minpeter/rule60-wrist-rest/evidence/topcase/analysis/outline-overlay-v4.png

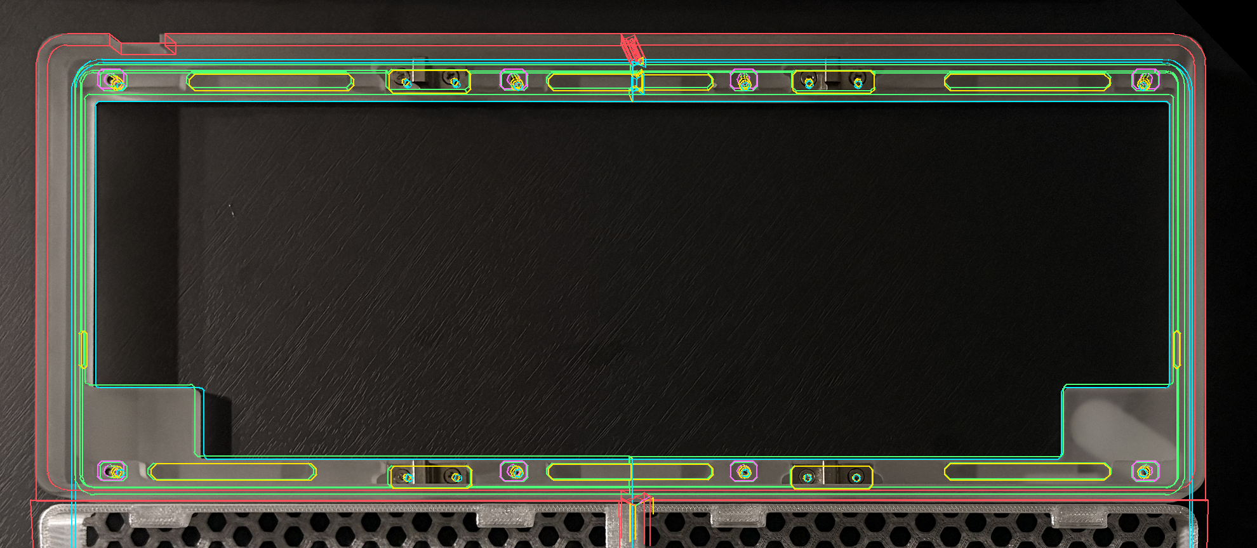
evidence/topcase/analysis/outline-overlay-v4.png
