minpeter/rule60-wrist-rest/evidence/topcase/analysis/strike-pocket-fit-v4.3.png

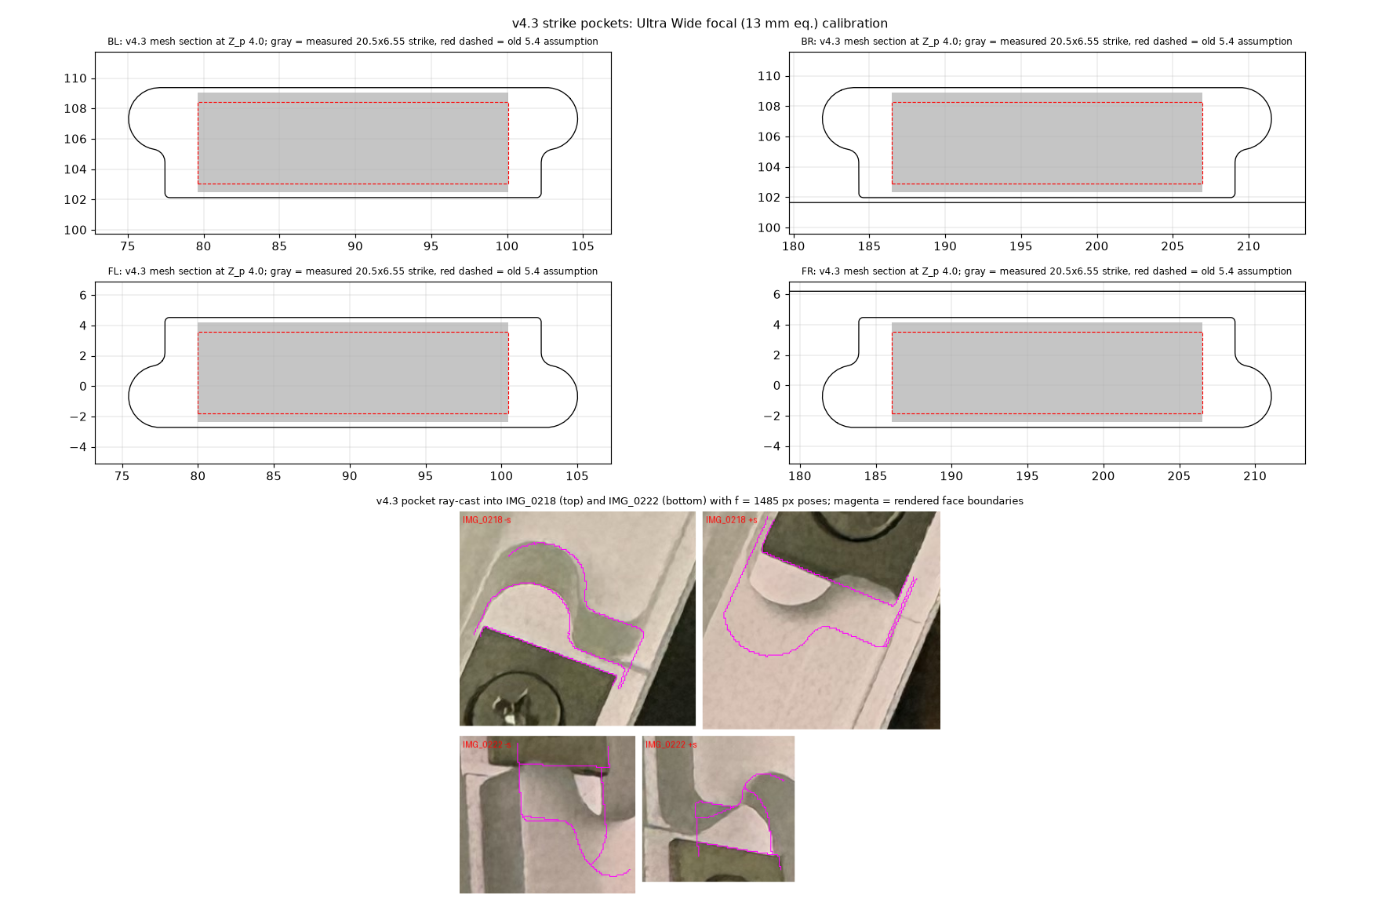
evidence/topcase/analysis/strike-pocket-fit-v4.3.png
