minpeter/rule60-wrist-rest/evidence/topcase/checks/seams-v7.4.png

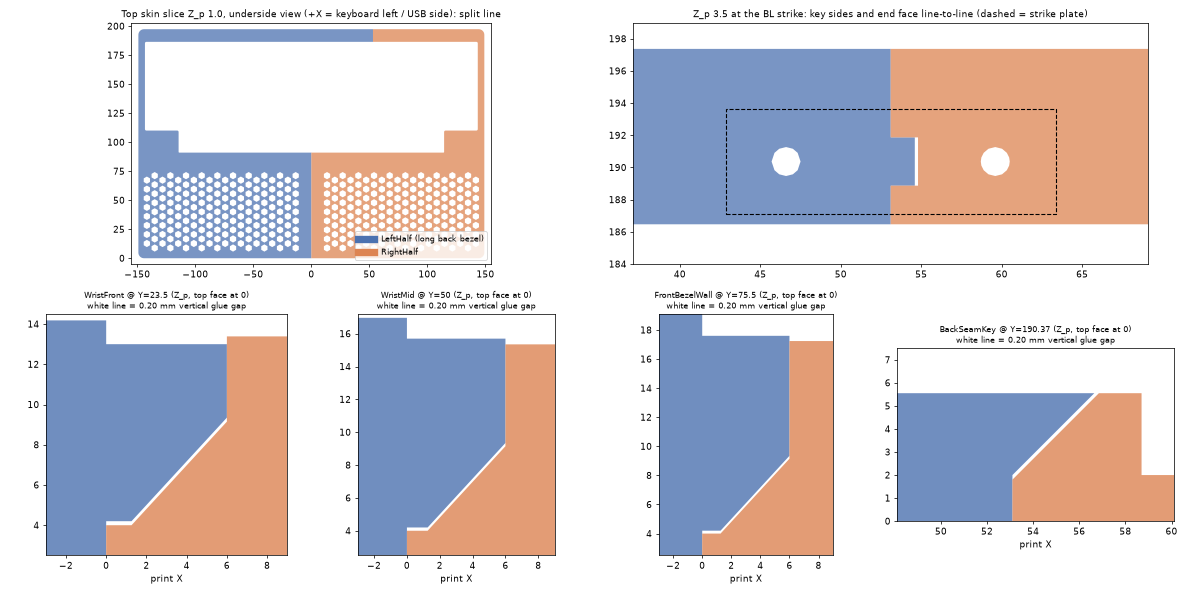
evidence/topcase/checks/seams-v7.4.png
