minpeter/rule60-wrist-rest/evidence/topcase/photos/IMG_0215.jpg

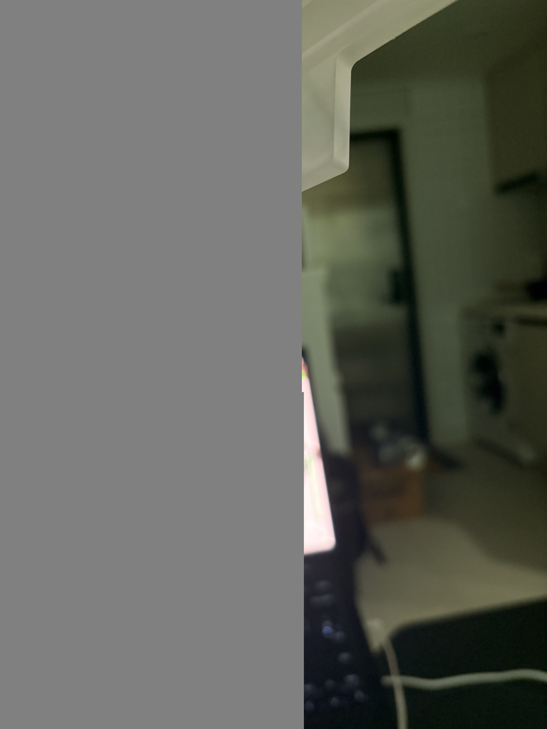
evidence/topcase/photos/IMG_0215.jpg
