minpeter/rule60-wrist-rest/evidence/topcase/photos/IMG_0216.jpg

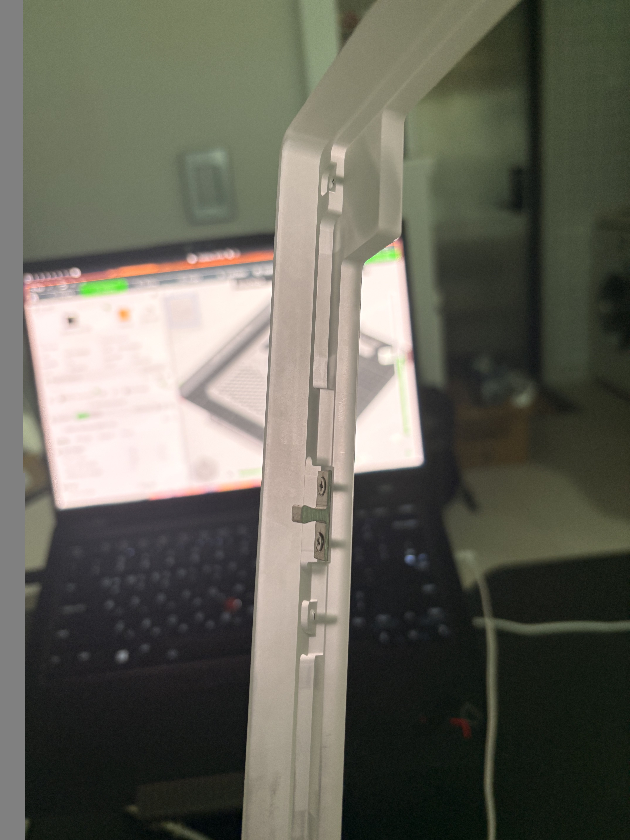
evidence/topcase/photos/IMG_0216.jpg
