minpeter/rule60-wrist-rest/evidence/topcase/photos/IMG_0217.jpg

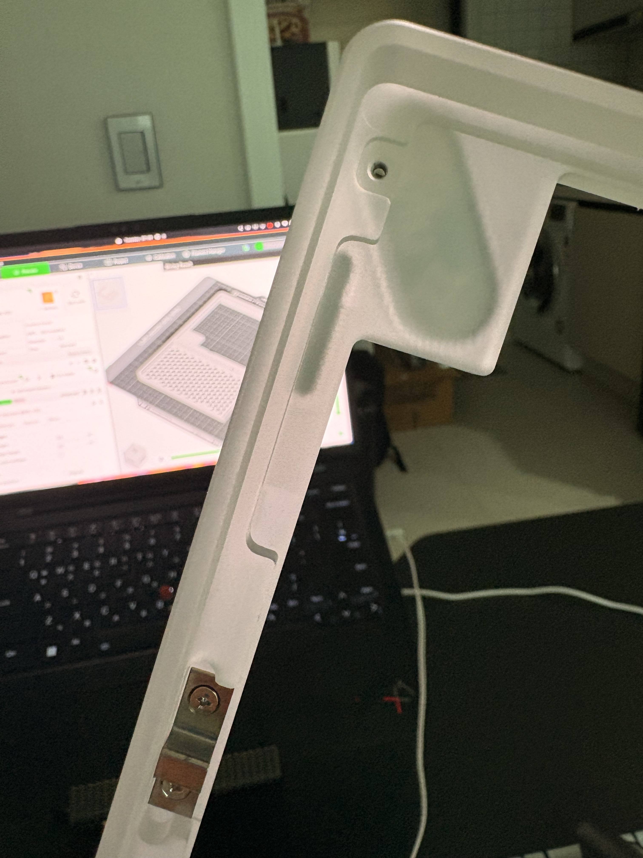
evidence/topcase/photos/IMG_0217.jpg
