minpeter/rule60-wrist-rest/evidence/topcase/photos/IMG_0218.jpg

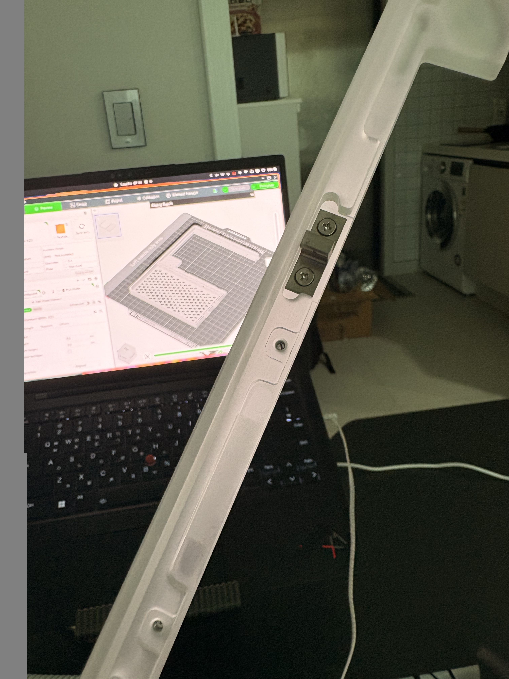
evidence/topcase/photos/IMG_0218.jpg
