minpeter/rule60-wrist-rest/evidence/topcase/photos/IMG_0220.jpg

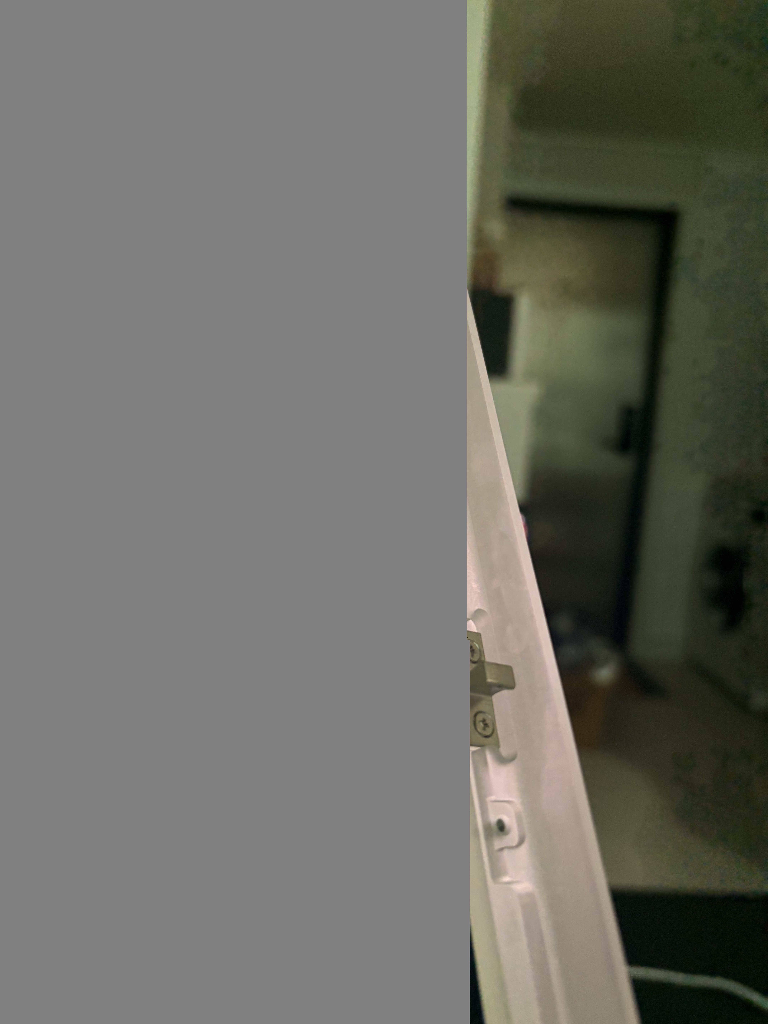
evidence/topcase/photos/IMG_0220.jpg
