minpeter/rule60-wrist-rest/evidence/topcase/photos/IMG_0222.jpg

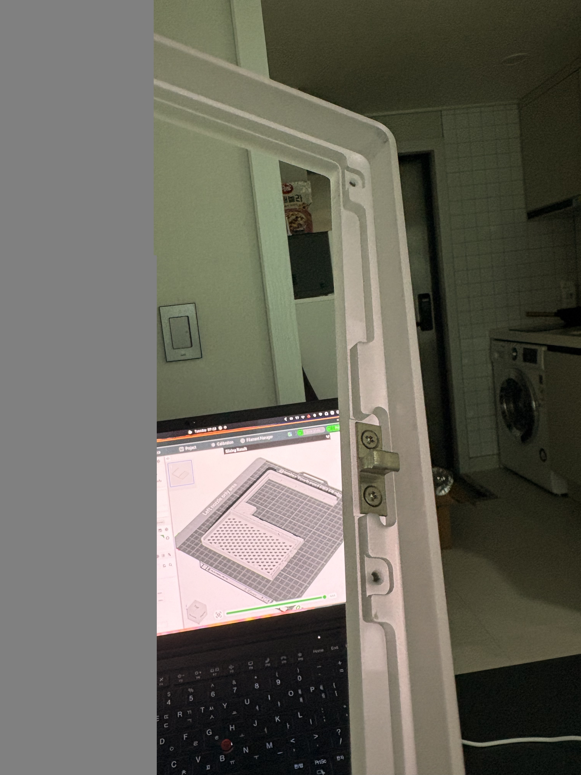
evidence/topcase/photos/IMG_0222.jpg
