minpeter/rule60-wrist-rest/evidence/topcase/photos/IMG_0313.jpg

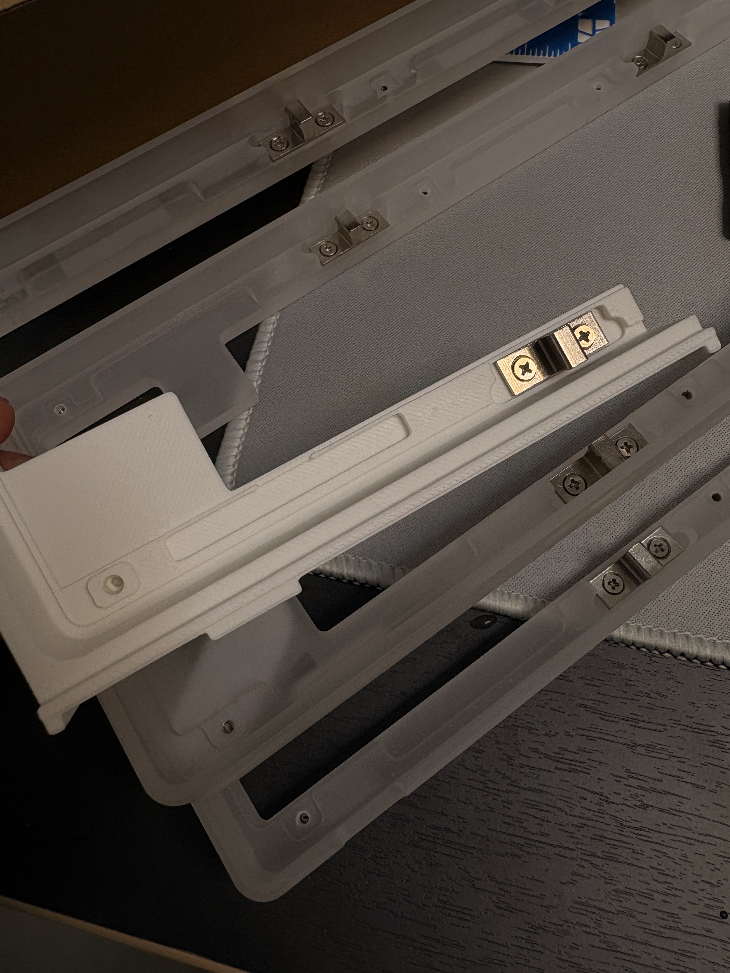
evidence/topcase/photos/IMG_0313.jpg
