minpeter/rule60-wrist-rest/evidence/topcase/photos/IMG_0314.jpg

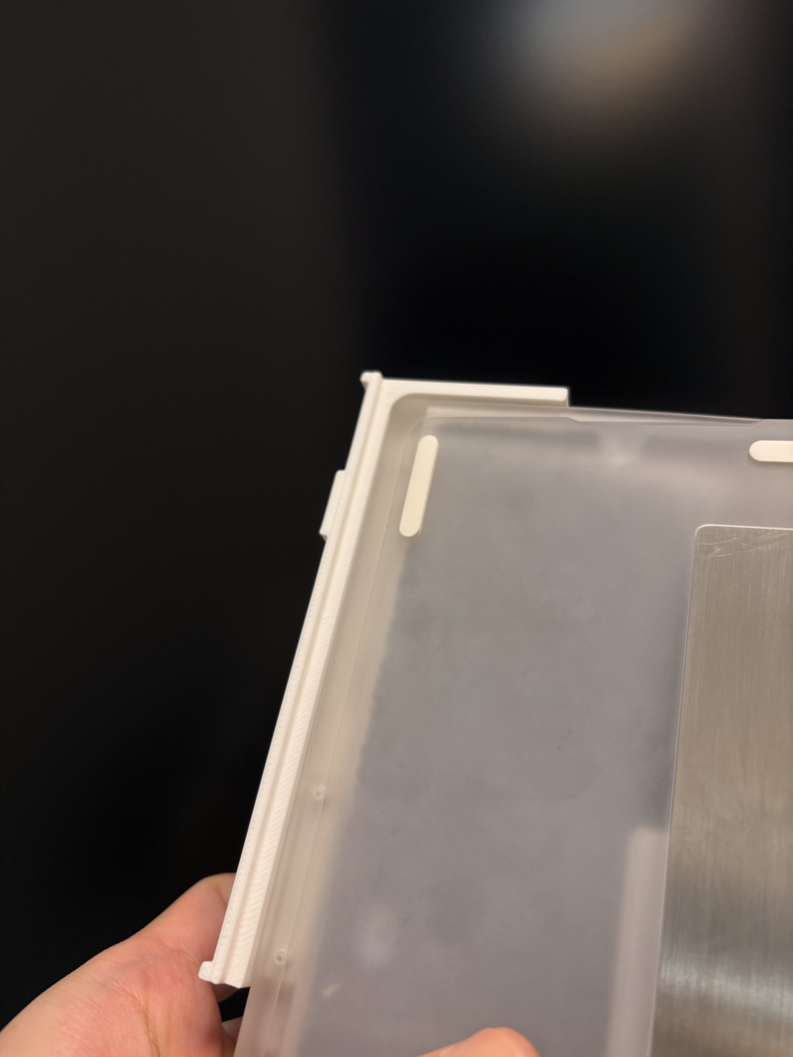
evidence/topcase/photos/IMG_0314.jpg
