minpeter/rule60-wrist-rest/evidence/topcase/photos/IMG_0340.jpg

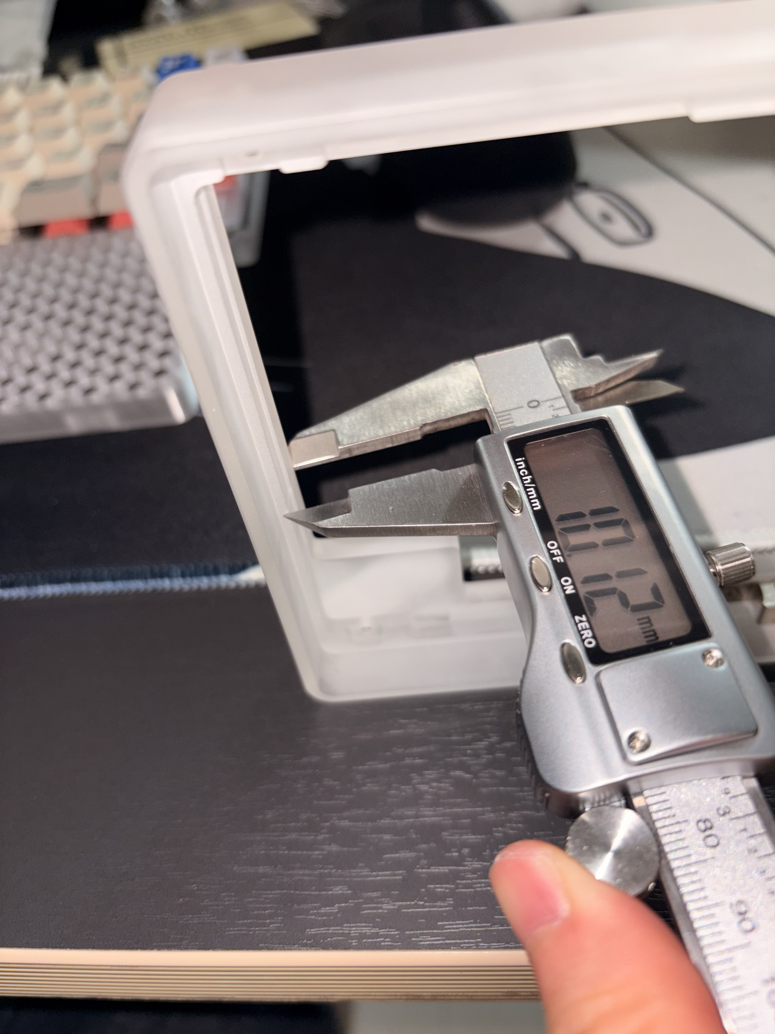
evidence/topcase/photos/IMG_0340.jpg
