minpeter/rule60-wrist-rest/evidence/topcase/photos/IMG_0341.jpg

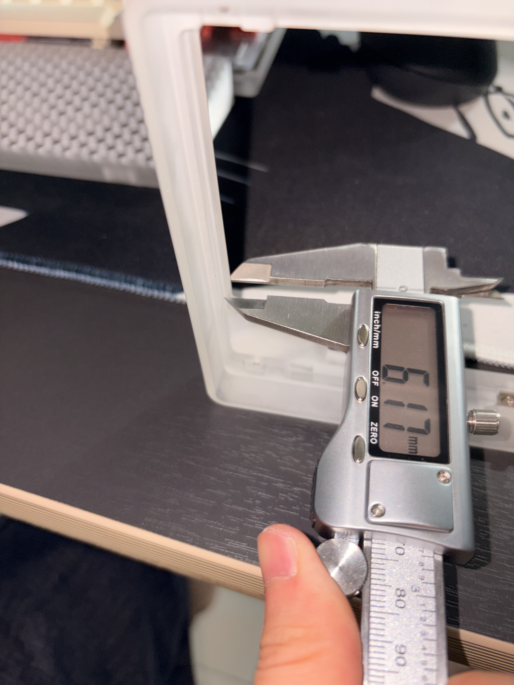
evidence/topcase/photos/IMG_0341.jpg
