minpeter/rule60-wrist-rest/evidence/topcase/photos/IMG_0370.jpg

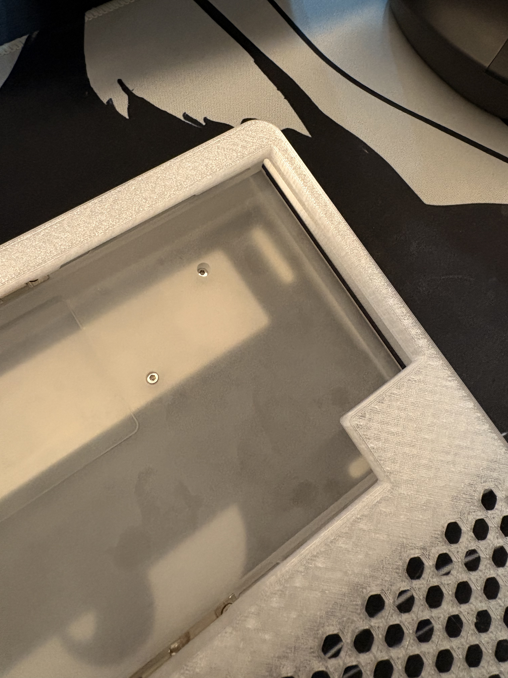
evidence/topcase/photos/IMG_0370.jpg
