minpeter/rule60-wrist-rest/evidence/topcase/photos/IMG_0371.jpg

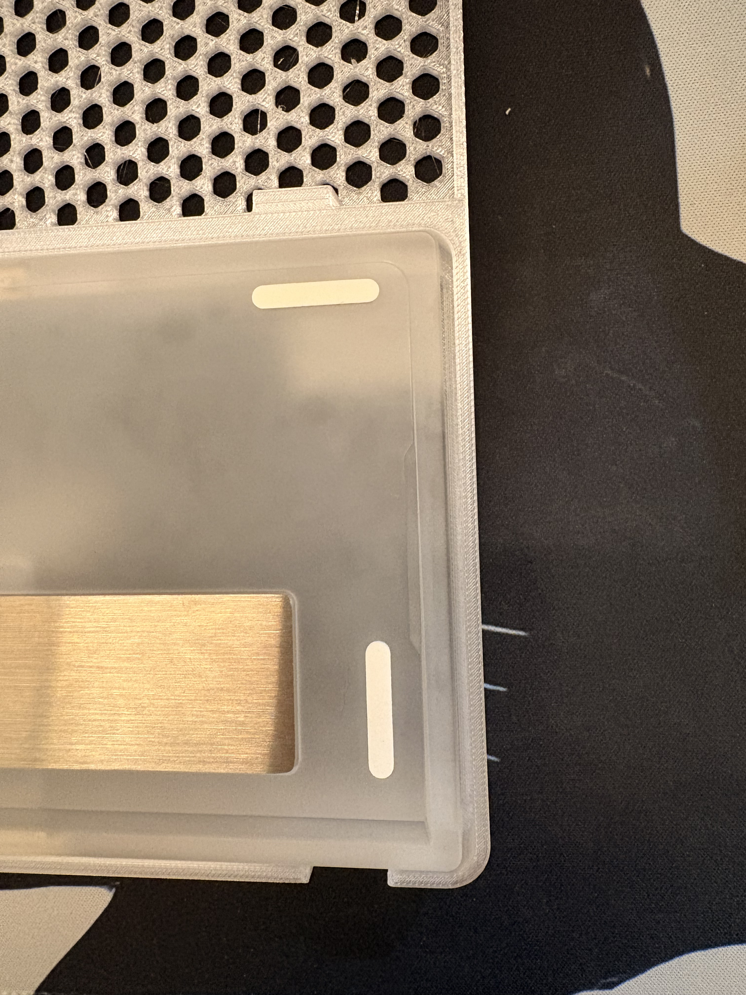
evidence/topcase/photos/IMG_0371.jpg
