minpeter/rule60-wrist-rest/evidence/topcase/photos/IMG_0373.jpg

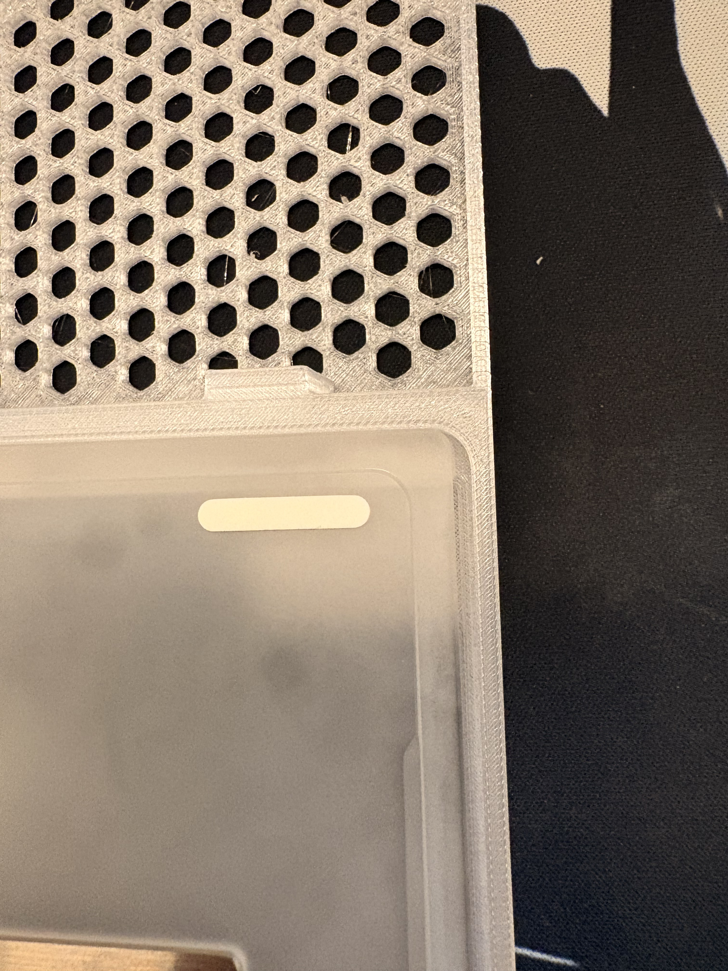
evidence/topcase/photos/IMG_0373.jpg
