minpeter/rule60-wrist-rest/evidence/topcase/photos/IMG_0375.jpg

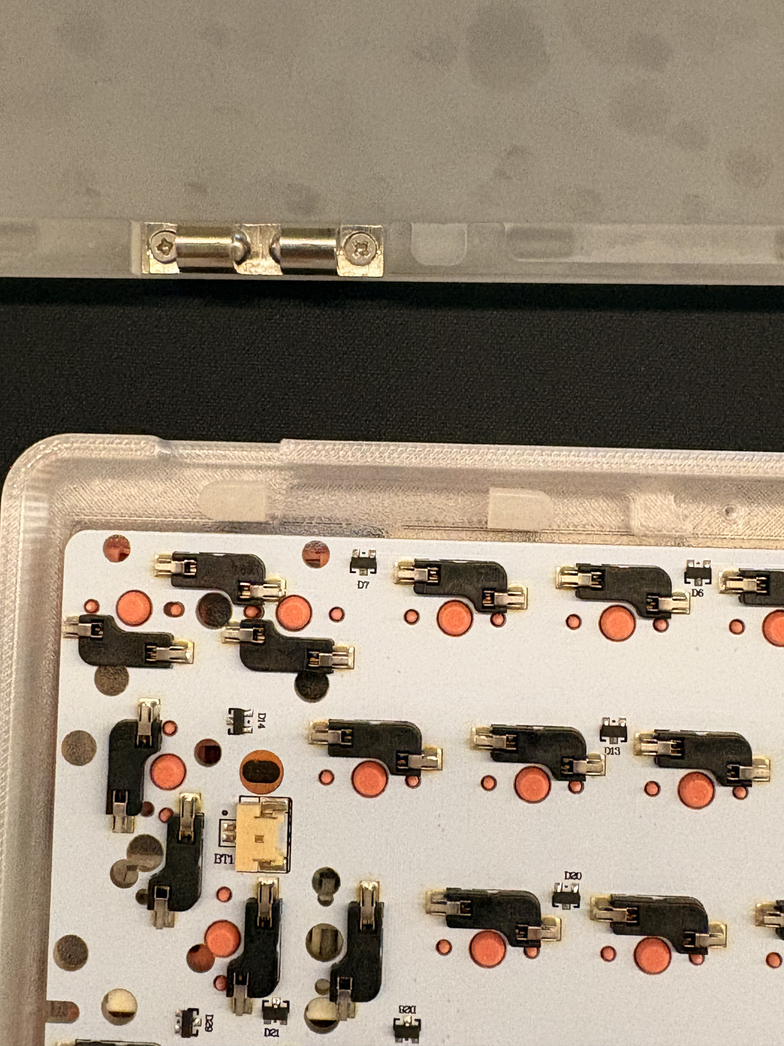
evidence/topcase/photos/IMG_0375.jpg
