minpeter/rule60-wrist-rest/evidence/topcase/photos/IMG_0378.jpg

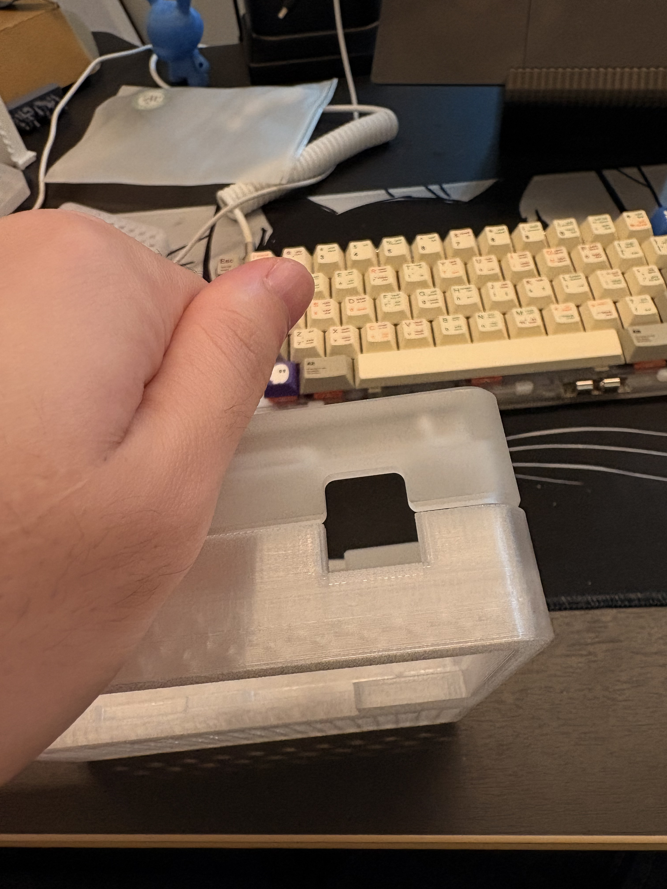
evidence/topcase/photos/IMG_0378.jpg
