minpeter/rule60-wrist-rest/evidence/topcase/photos/IMG_0379.jpg

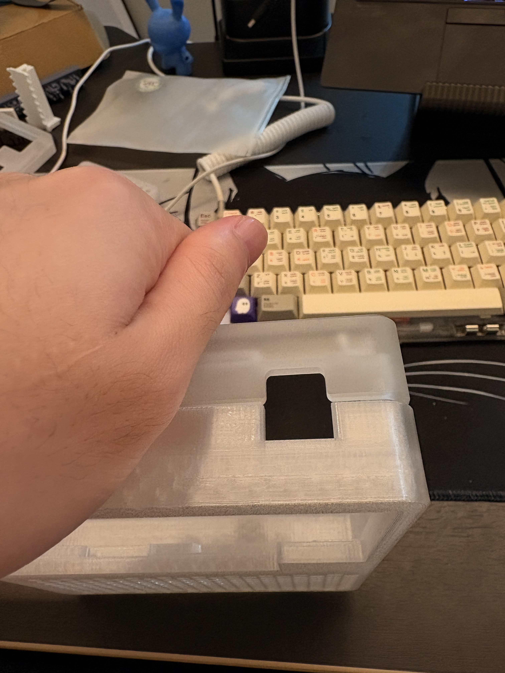
evidence/topcase/photos/IMG_0379.jpg
