minpeter/rule60-wrist-rest/images/top.png

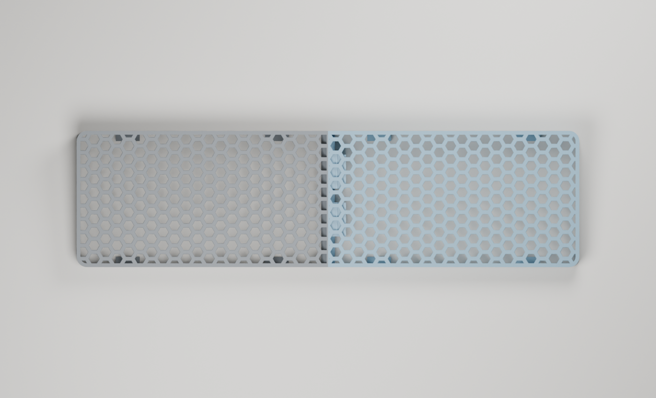
images/top.png
