minpeter/rule60-wrist-rest/rendering/v7_1/keycaps_v7_1/textures/0_1.png

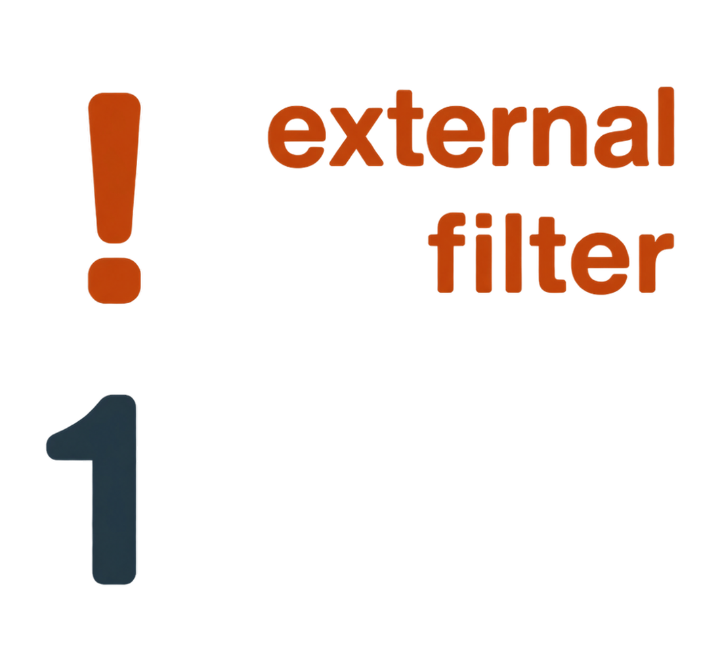
rendering/v7_1/keycaps_v7_1/textures/0_1.png
