minpeter/rule60-wrist-rest/rendering/v7_1/keycaps_v7_1/textures/3_LeftShift.png

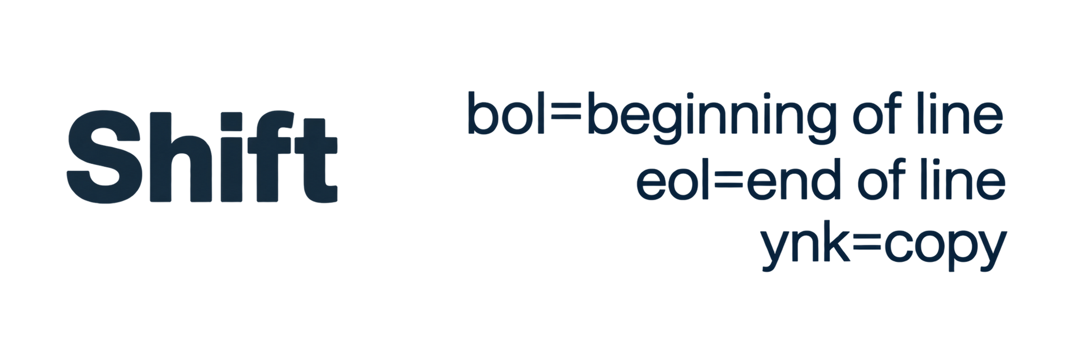
rendering/v7_1/keycaps_v7_1/textures/3_LeftShift.png
