minpeter/rule60-wrist-rest/rendering/v7_1/sample_frame_007.png

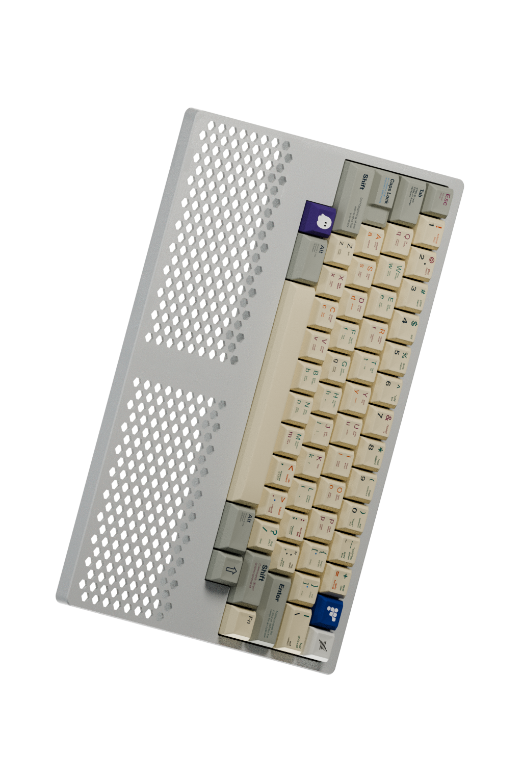
rendering/v7_1/sample_frame_007.png
