minpeter/rule60-wrist-rest/rendering/v7_1/shell_assembled.stl

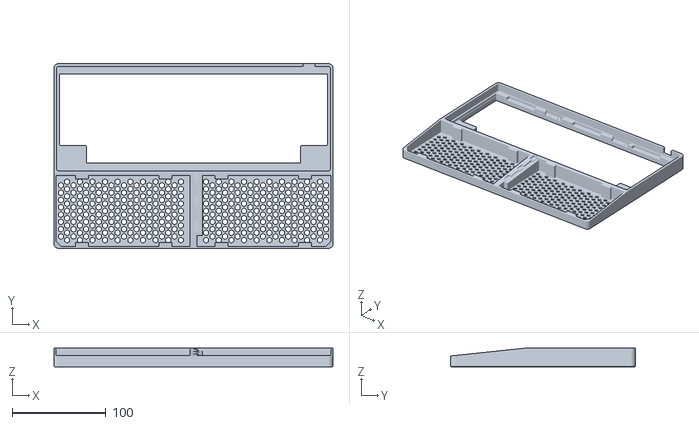
[picture p94: CAD file, 2026-10-31]
rendering/v7_1/shell_assembled.stl
298.1 x 197.4 x 20.1
