minpeter/rule60-wrist-rest/models/rule60-hhkb-topcase-fit-coupons.3mf

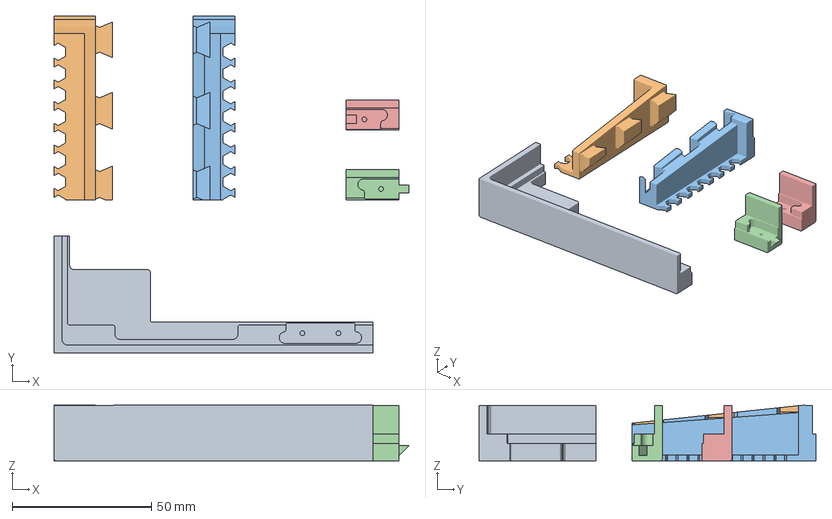
[picture p95: CAD file, 2026-10-30]
models/rule60-hhkb-topcase-fit-coupons.3mf
127.6 x 121.0 x 20.1 mm
CornerCatchBossCoupon
FrontJointLeft
FrontJointRight
BackSeamLeft
BackSeamRight
