minpeter/rule60-wrist-rest/models/rule60-hhkb-topcase-right.3mf

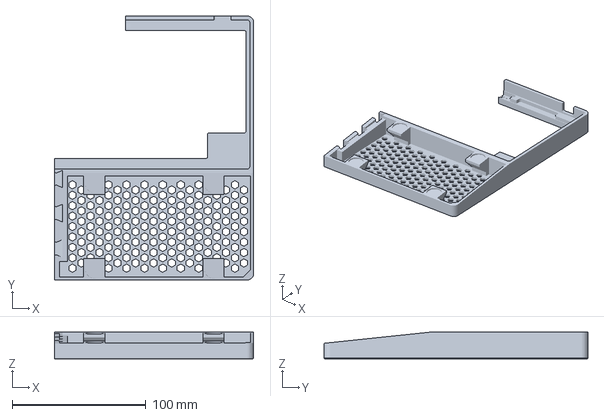
[picture p96: CAD file, 2026-10-30]
models/rule60-hhkb-topcase-right.3mf
149.1 x 197.4 x 20.1 mm
