minpeter/rule60-wrist-rest/models/rule60-hhkb-topcase-left.3mf

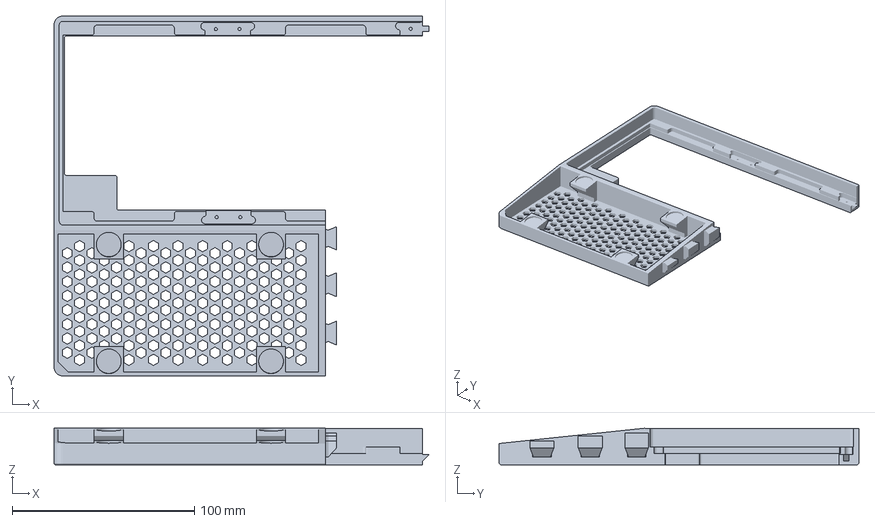
[picture p97: CAD file, 2026-10-30]
models/rule60-hhkb-topcase-left.3mf
205.7 x 197.4 x 20.1 mm
