minpeter/rule60-wrist-rest/models/right.stl

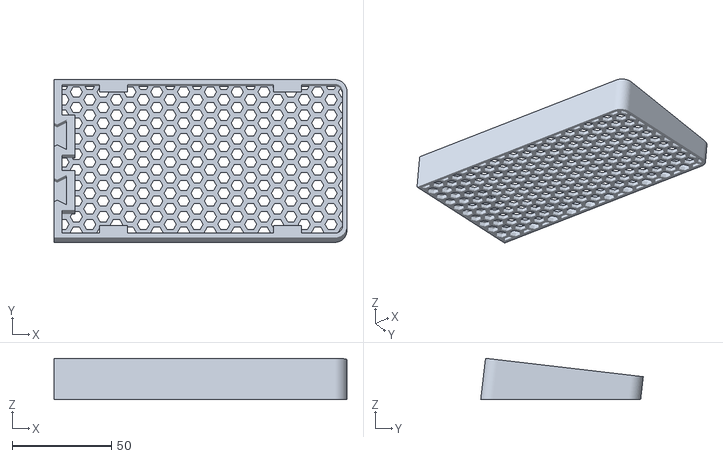
[picture p98: CAD file, 2026-10-25]
models/right.stl
147.5 x 81.9 x 20.9
