minpeter/rule60-wrist-rest/models/rule60-one-plate.stl

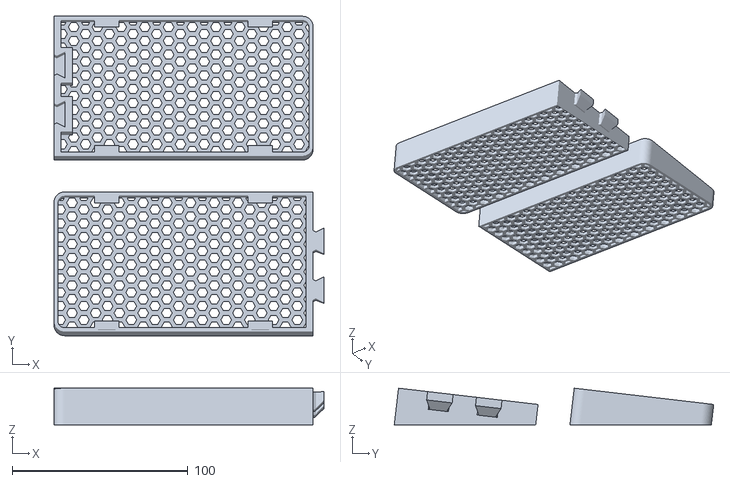
[picture p99: CAD file, 2026-10-25]
models/rule60-one-plate.stl
153.7 x 181.9 x 20.9
