minpeter/rule60-wrist-rest/models/left.stl

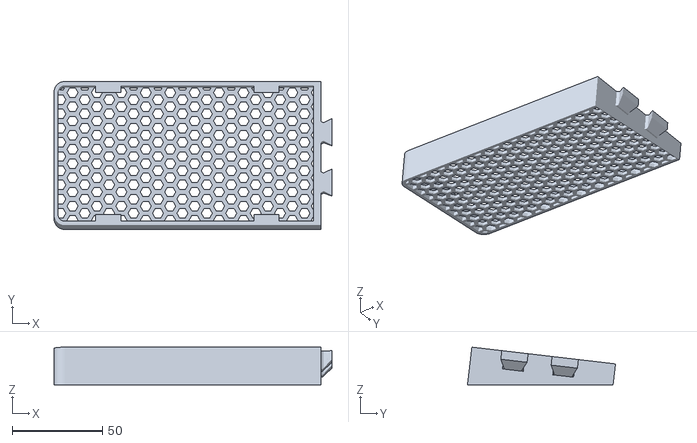
[picture p100: CAD file, 2026-10-25]
models/left.stl
153.7 x 81.9 x 20.9
