minpeter/rule60-wrist-rest/models/rule60-v9-joint-test.3mf

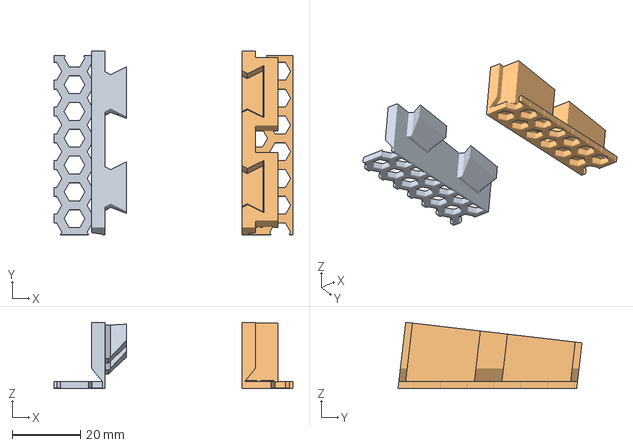
[picture p101: CAD file, 2026-10-25]
models/rule60-v9-joint-test.3mf
70.0 x 53.9 x 19.5 mm
left
right
