minpeter/rule60-wrist-rest/models/rule60-tight-fit-test-left.3mf

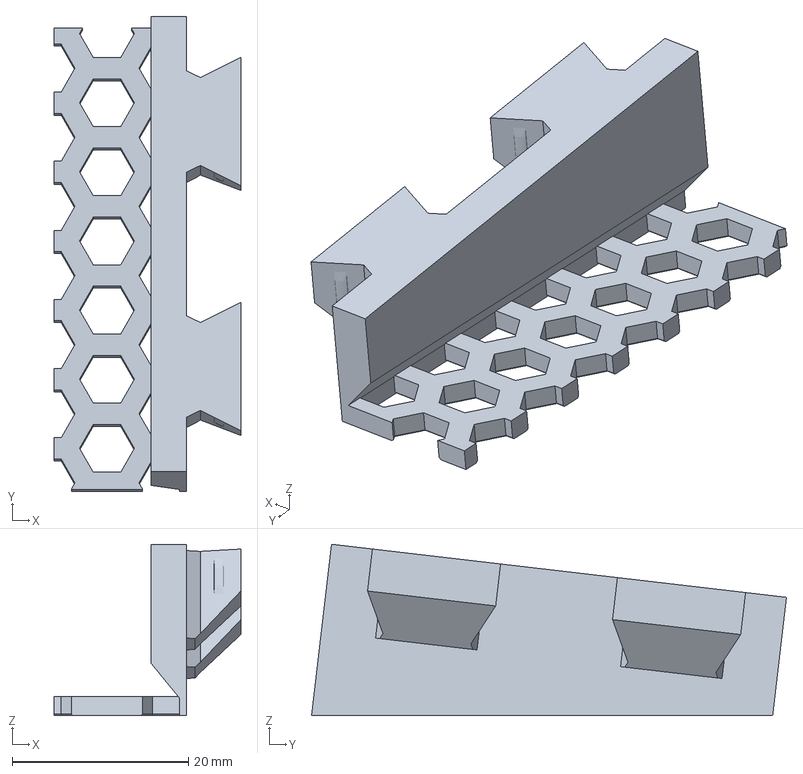
[picture p102: CAD file, 2026-10-25]
models/rule60-tight-fit-test-left.3mf
21.2 x 53.9 x 19.5 mm
