minpeter/rule60-wrist-rest/models/rule60-v9-surface-pad-test.3mf

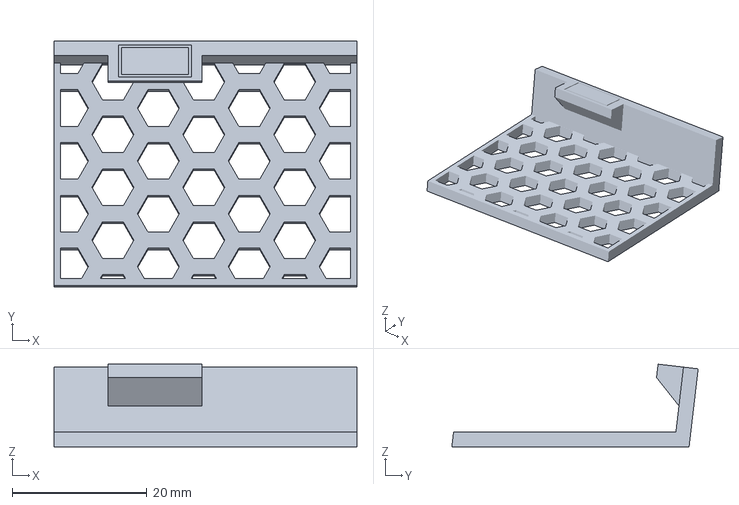
[picture p103: CAD file, 2026-10-25]
models/rule60-v9-surface-pad-test.3mf
45.0 x 36.6 x 12.3 mm
