minpeter/rule60-wrist-rest/(list of files, cad)

Other CAD files:
rendering/v7_1/rule60-hhkb-topcase.step
models/rule60-hhkb-topcase.step
models/rule60-tight-fit-left.3mf
models/rule60-v9-honeycomb-body.3mf
