minpeter/rule60-wrist-rest/evidence/topcase/analysis/measurement-guide.png

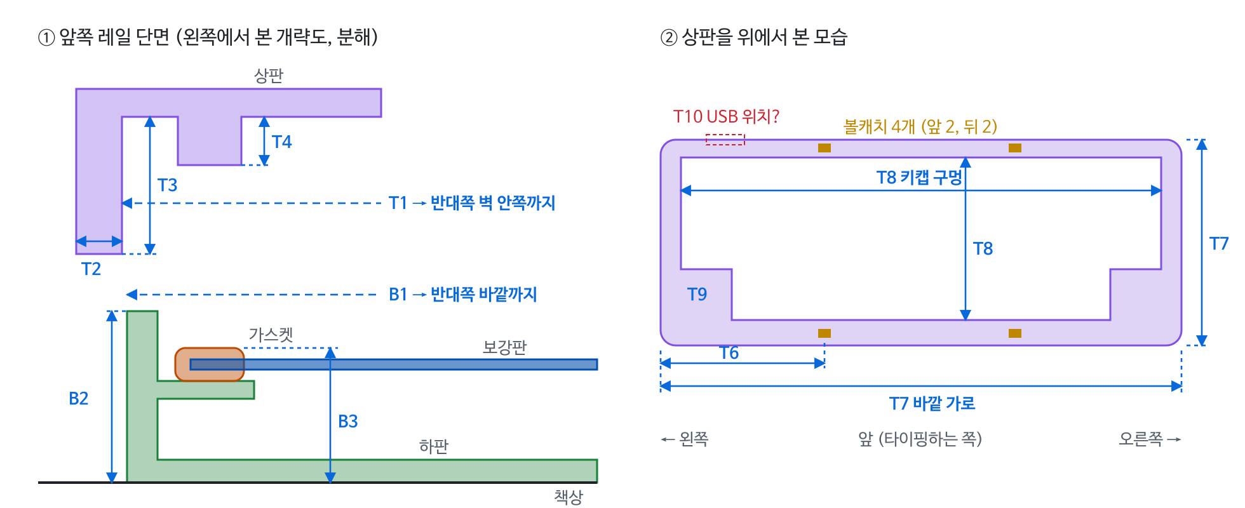
evidence/topcase/analysis/measurement-guide.png
