minpeter/rule60-wrist-rest/images/assembled.png

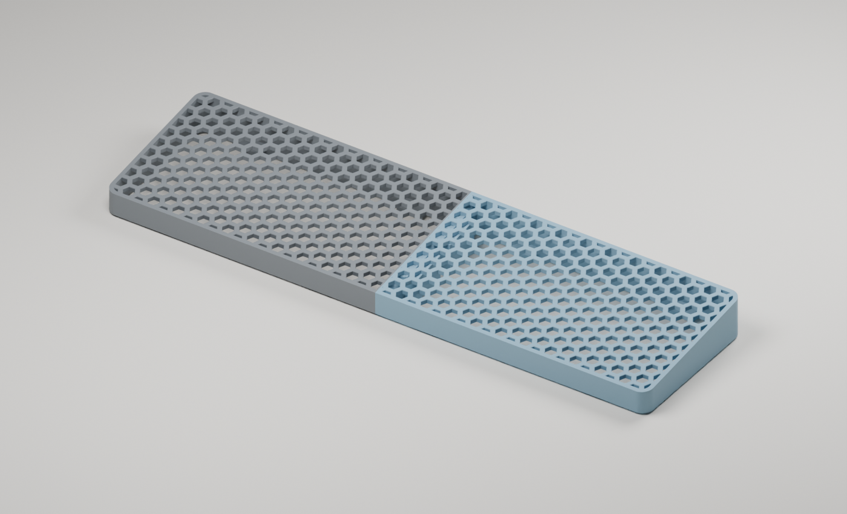
images/assembled.png
