minpeter/rule60-wrist-rest/(commit log)

2026-10-25 Publish Rule 60 V3 honeycomb wrist rest v9 under CC BY 4.0
    Include reproducible geometry sources, model plates, renders and verification evidence.
    Amp-Thread-ID: https://ampcode.com/threads/T-01a16e4b-c321-7750-ad9d-5066df5680ee
    [rule60-v9-honeycomb-body.3mf, rule60-v9-joint-test.3mf, rule60-v9-surface-pad-test.3mf]
2026-10-25 Show dovetail joint detail in README
    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
2026-10-25 Link MakerWorld listing from README
    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
2026-10-25 Publish tested tight-fit wrist rest geometry and STL downloads
    Preserve the v9 receiver and close the male gap with local compression ribs. Update model exports, verification evidence, and reproduction instructions after the owner confirmed coupon fit.
    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
    [left.stl, right.stl, rule60-one-plate.stl, rule60-tight-fit-left.3mf, rule60-tight-fit-test-left.3mf, rule60-v9-honeycomb-body.3mf, rule60-v9-joint-test.3mf]
2026-10-25 Make STL downloads watertight after float32 conversion
    Remove only collapsed triangles after binary conversion and validate reloaded meshes, component counts, bounds, and volume.
    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
    [left.stl, right.stl, rule60-one-plate.stl]
2026-10-29 Add HHKB top case with integrated wrist rest (experimental)
    Replacement Rule 60 V3 HHKB top case that reuses the stock bottom case,
    PC gasket plate, silicone caps and ball-catch strikes, generated from
    caliper measurements through the SolidCraft headless CLI.
    - Staggered split: three centre dovetails; the back bezel runs on to the
    back-right strike, whose stock plate bridges the seam with one M2 per half
    - Line-to-line joint side faces, 0.20 mm vertical glue lines, socket fills
    under every 45-degree print ramp, no supports
    - Print 3MFs carry a 0.10 mm layer range over the pocket floors
    - verify_topcase.py checks insertion path, glue lines, back seam, layer
    islands/overhangs and virtua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
    [rule60-hhkb-topcase-fit-coupons.3mf, rule60-hhkb-topcase-left.3mf, rule60-hhkb-topcase-right.3mf, rule60-hhkb-topcase.step]
2026-10-29 Add top-case measurements, photos, analysis and render gallery
    - evidence/topcase/README.md: every caliper value with its photo/source and
    the design constant it sets, photo-derived values and method, photo index
    - 22 measurement and coupon photos, resized, all EXIF/GPS removed
    - Analysis images (annotated underside, outline overlay, strike-pocket fit,
    measurement guide), ball-catch analysis, DWG source manifest
    - as-printed re-check, seam sections and underside level map for v6.2
    - All four renders exported and shown in the README
2026-10-29 Publish top-case photos at original resolution with metadata removed
    Lossless JPEG segment rewrite: decoded pixels identical to the camera
    files; EXIF (incl. GPS), XMP, JFIF and the MPF gain-map image dropped,
    orientation flag and ICC profile kept. The annotated underside image is
    restored to its original bytes (it carried no metadata).
2026-10-30 Fix mirrored top case, pocket corners and USB-C notch from the first full print (v7.4)
    - v6.2 printed the mirror image: the DWG plate frame is a top view, the print
    frame the underside. Plate X is now mirrored into print X everywhere
    (build and verify share the convention); the back seam moves to the BL
    strike. The USB-C notch was on the wrong side and the two outer back gasket
    pockets sat 10.12 mm off their tabs.
    - verify_topcase.py checks the USB-C notch side, width and depth and the
    inward back-left gasket pocket; it fails on the mirrored v6.2.
    - Bottom-case pocket corners R5.0 -> R2.0 (stock bottom case stood ~2.3 mm
    off at the corners); outer corners R8.0 -> R4.85, concentri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
    [rule60-hhkb-topcase-fit-coupons.3mf, rule60-hhkb-topcase-left.3mf, rule60-hhkb-topcase-right.3mf, rule60-hhkb-topcase.step]
2026-10-30 Record v7.4 half print: no major issues reported
2026-10-30 Record v7.4 right half print
2026-10-30 Extend wrist-rest bumpon pads to 11 mm for 3M SJ5302 (v7.5)
    [rule60-hhkb-topcase-fit-coupons.3mf, rule60-hhkb-topcase-left.3mf, rule60-hhkb-topcase-right.3mf, rule60-hhkb-topcase.step]
2026-10-30 Seat 3M SJ5012 bumpons in wrist-rest pockets (v7.6)
    [rule60-hhkb-topcase-fit-coupons.3mf, rule60-hhkb-topcase-left.3mf, rule60-hhkb-topcase-right.3mf, rule60-hhkb-topcase.step]
2026-10-30 Move USB-C notch 2 mm outward (v7.7)
    [rule60-hhkb-topcase-fit-coupons.3mf, rule60-hhkb-topcase-left.3mf, rule60-hhkb-topcase-right.3mf, rule60-hhkb-topcase.step]
2026-10-30 License the HHKB top case under CC BY-NC 4.0 (non-commercial only), across all versions
    The wrist rest stays CC BY 4.0. Adds LICENSE-topcase, lists the top-case
    files in the README, and updates the License metadata in the generator and
    the published top-case 3MFs (geometry unchanged).
    [rule60-hhkb-topcase-fit-coupons.3mf, rule60-hhkb-topcase-left.3mf, rule60-hhkb-topcase-right.3mf]
2026-10-31 Back up keyboard studio v7.1 source, keycaps, packed scene and provenance
    [rule60-hhkb-topcase.step, shell_assembled.stl]
