minpeter/rule60-wrist-rest/evidence/topcase/photos/IMG_0201.jpg

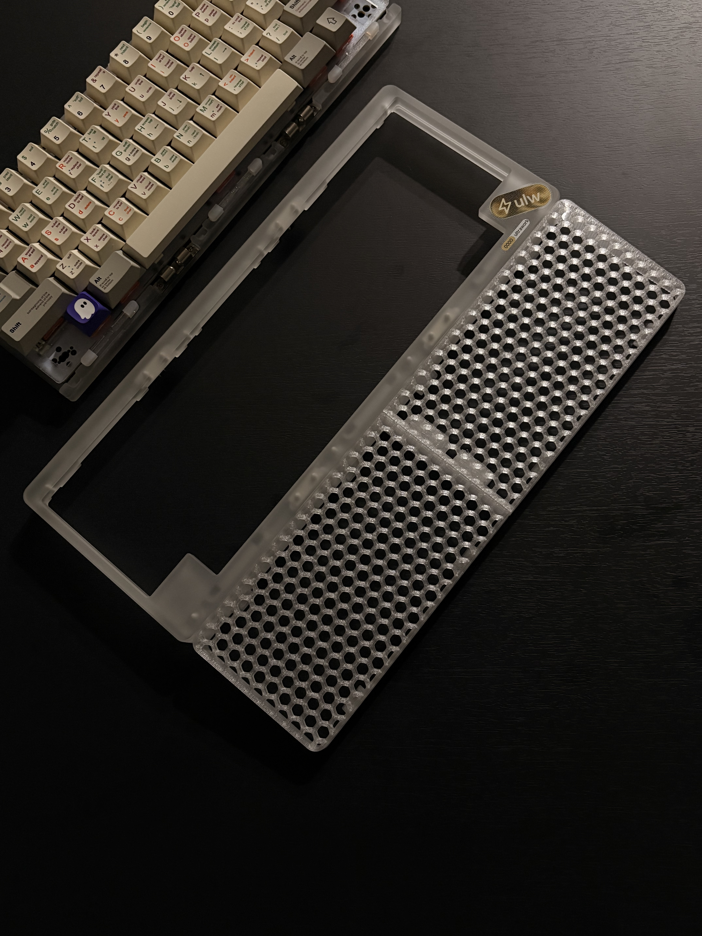
evidence/topcase/photos/IMG_0201.jpg
