minpeter/rule60-wrist-rest/evidence/topcase/photos/IMG_0202.jpg

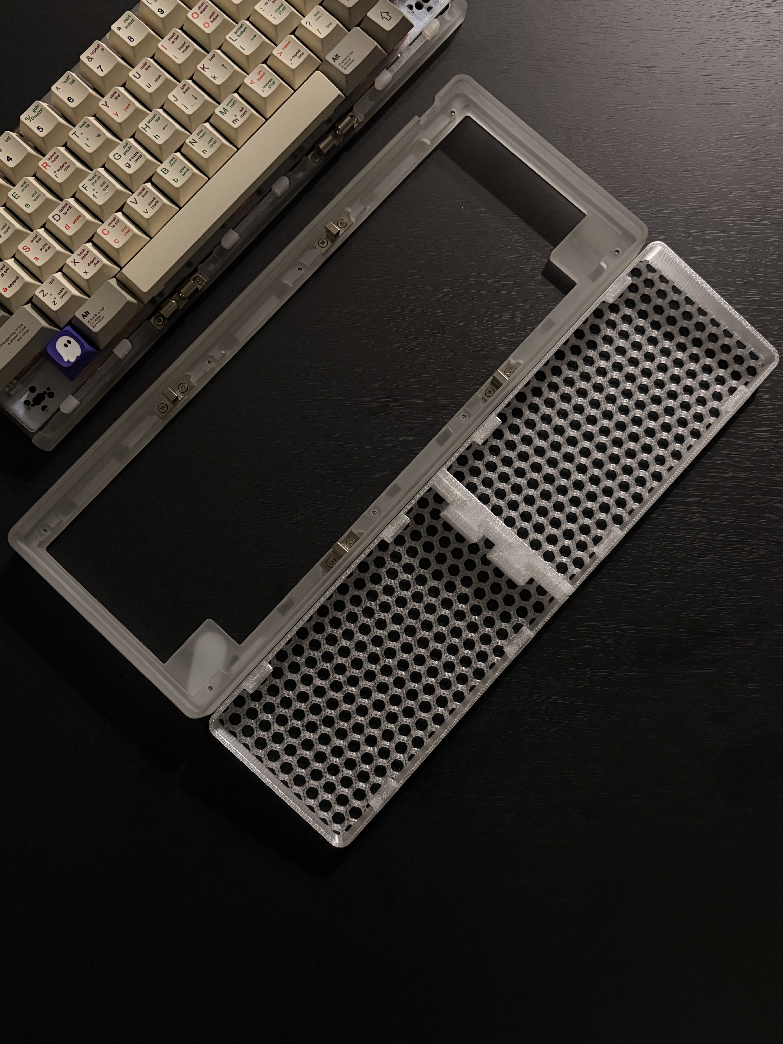
evidence/topcase/photos/IMG_0202.jpg
