minpeter/rule60-wrist-rest/evidence/topcase/photos/IMG_0315.jpg

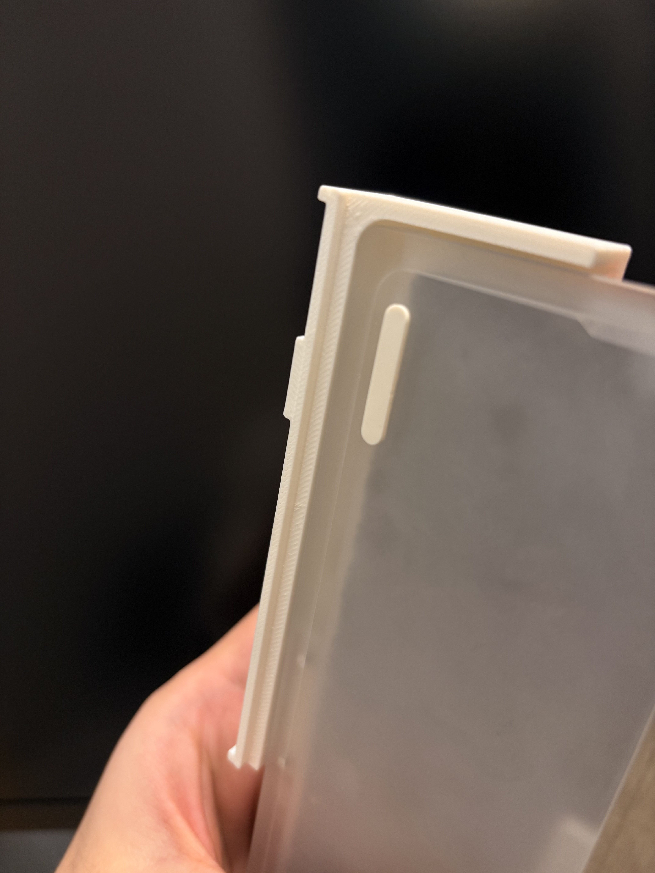
evidence/topcase/photos/IMG_0315.jpg
