minpeter/rule60-wrist-rest/evidence/topcase/photos/IMG_0316.jpg

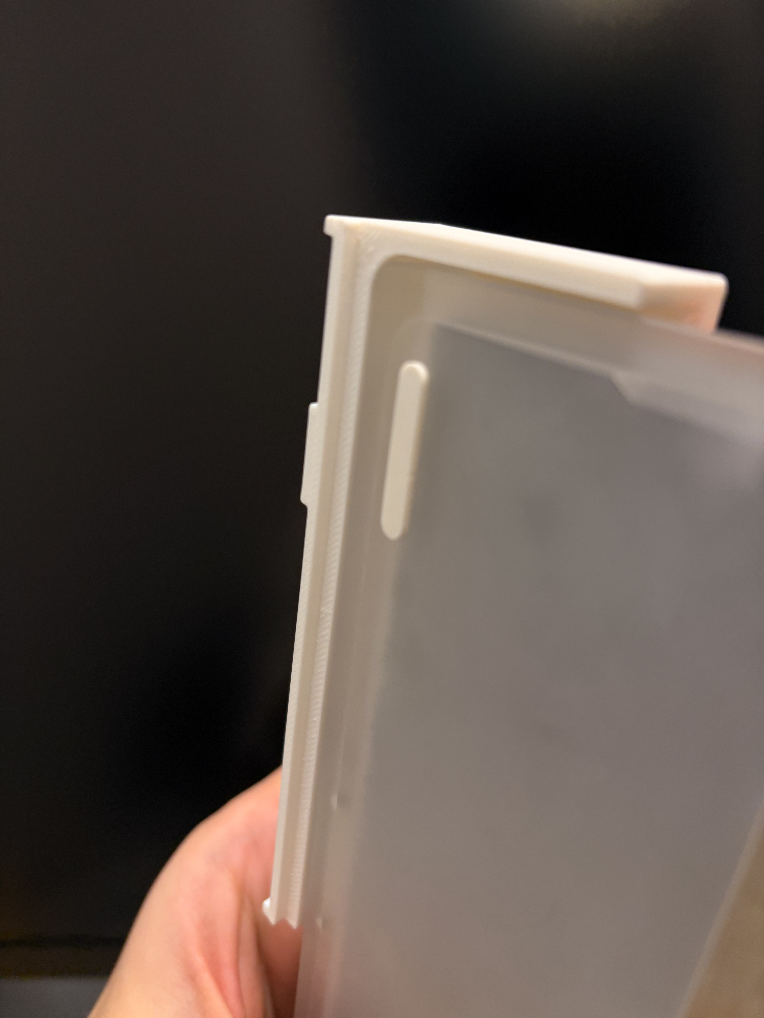
evidence/topcase/photos/IMG_0316.jpg
