minpeter/rule60-wrist-rest/evidence/topcase/photos/IMG_0317.jpg

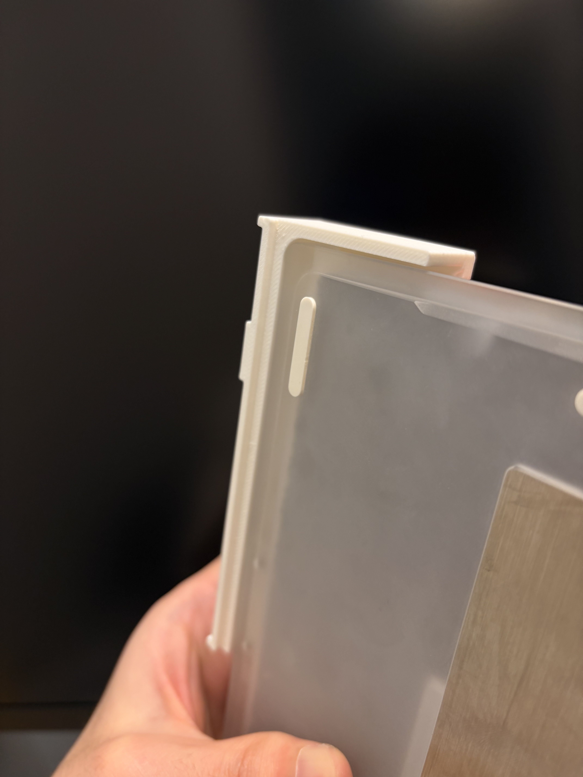
evidence/topcase/photos/IMG_0317.jpg
