minpeter/rule60-wrist-rest/evidence/topcase/photos/IMG_0318.jpg

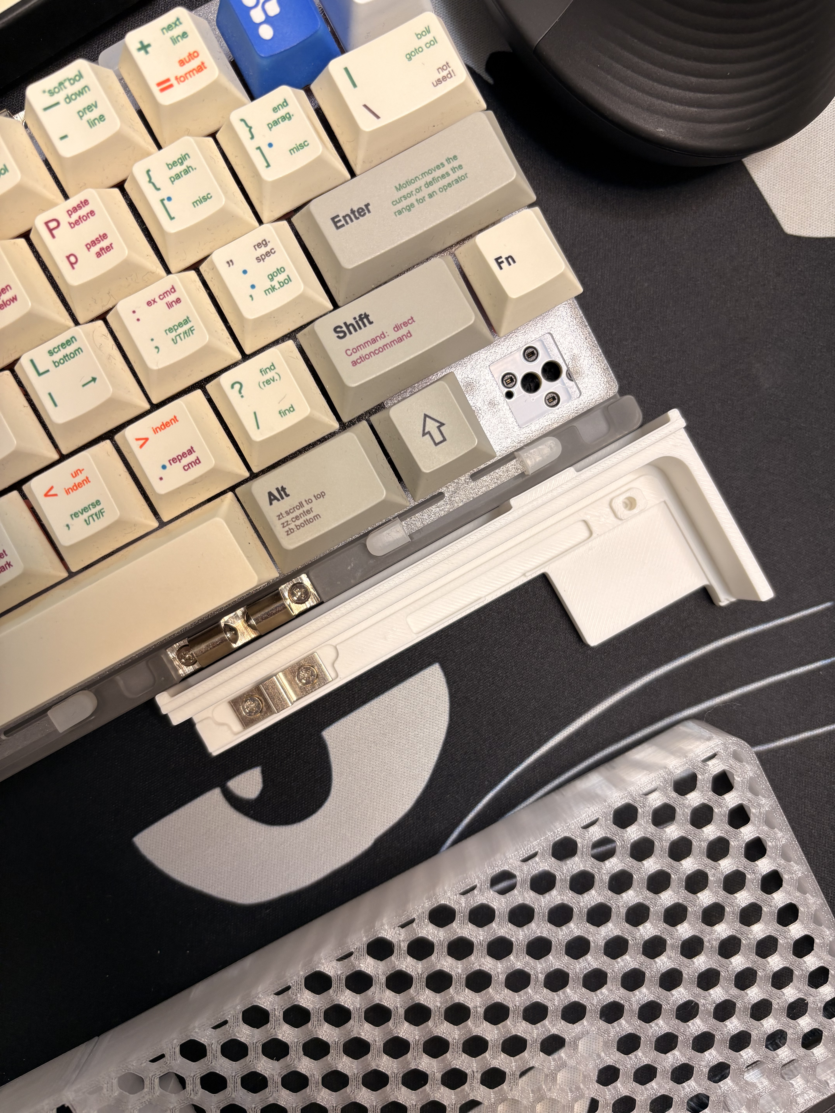
evidence/topcase/photos/IMG_0318.jpg
