minpeter/rule60-wrist-rest/evidence/topcase/photos/IMG_0319.jpg

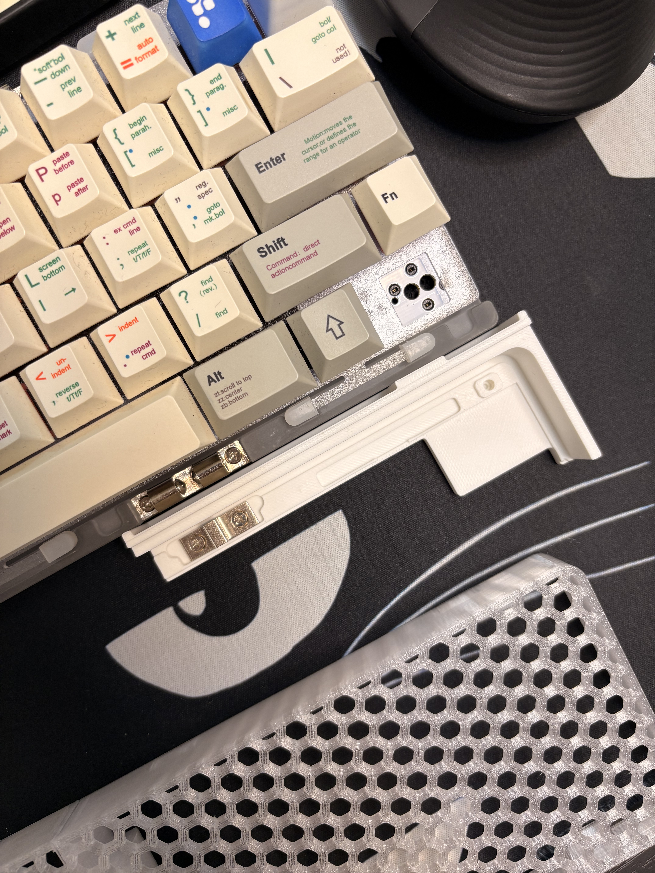
evidence/topcase/photos/IMG_0319.jpg
