minpeter/rule60-wrist-rest/evidence/topcase/photos/IMG_0333.jpg

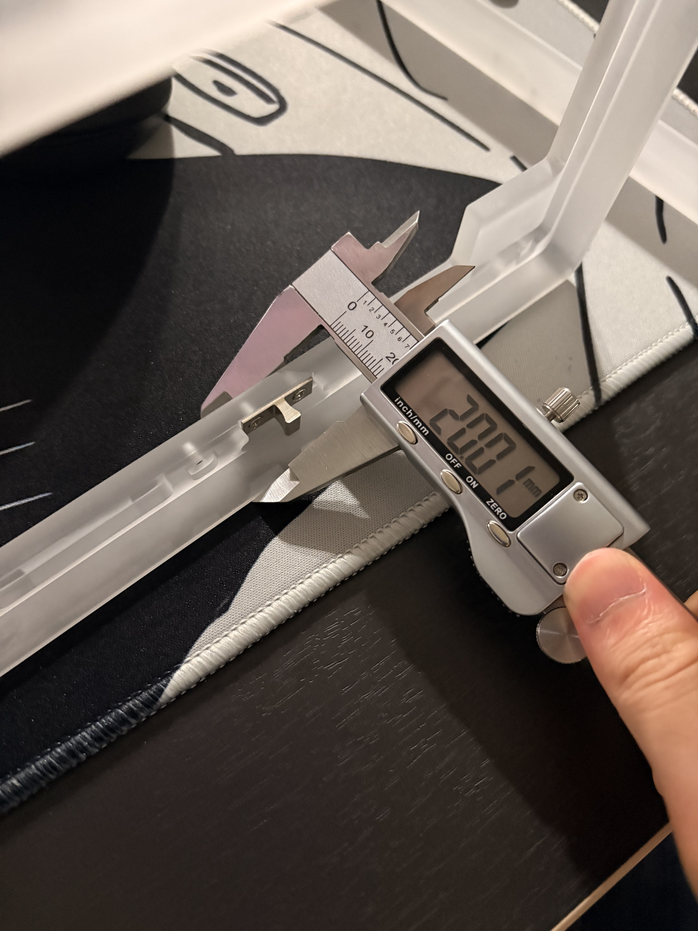
evidence/topcase/photos/IMG_0333.jpg
