minpeter/rule60-wrist-rest/evidence/topcase/photos/IMG_0334.jpg

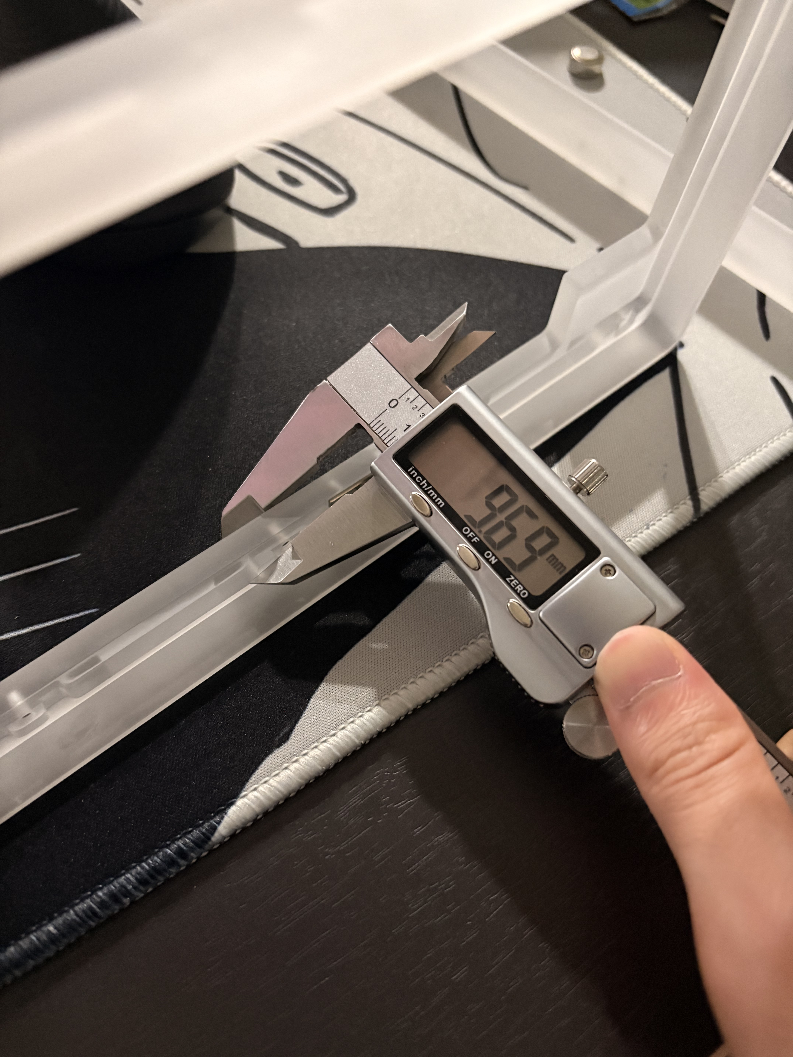
evidence/topcase/photos/IMG_0334.jpg
