minpeter/rule60-wrist-rest/evidence/topcase/photos/IMG_0335.jpg

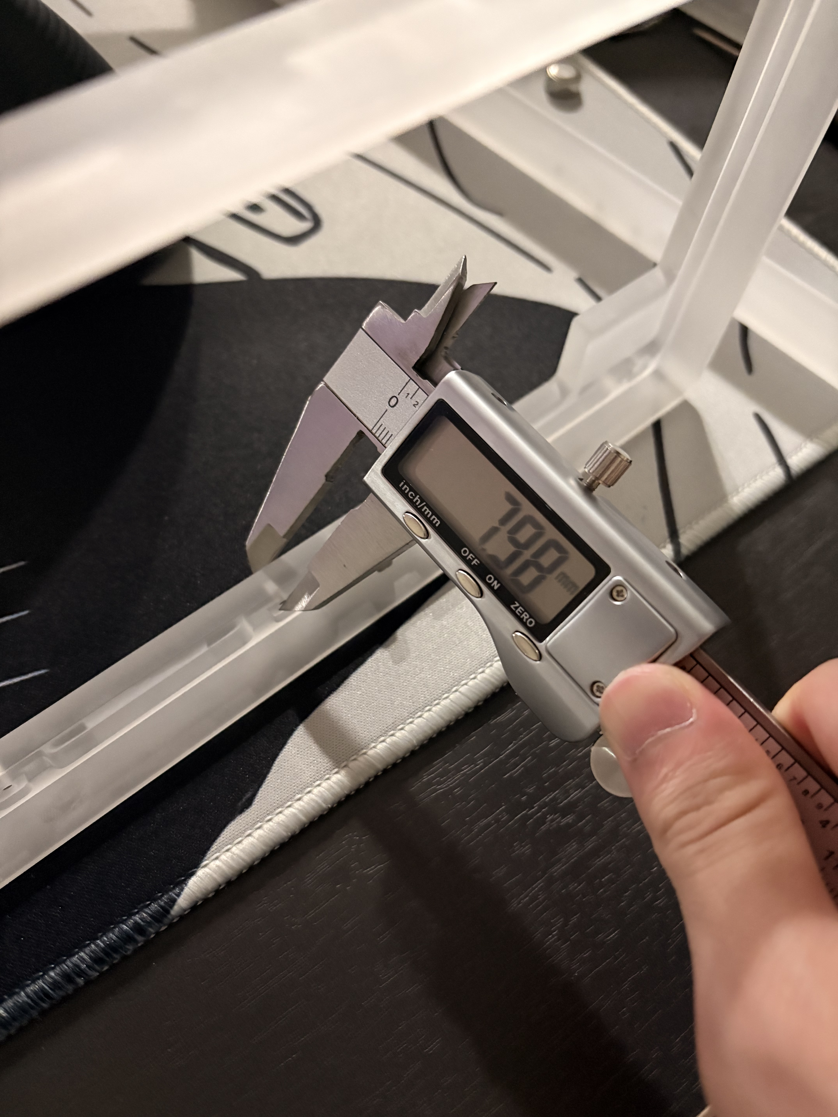
evidence/topcase/photos/IMG_0335.jpg
