minpeter/rule60-wrist-rest/evidence/topcase/photos/IMG_0336.jpg

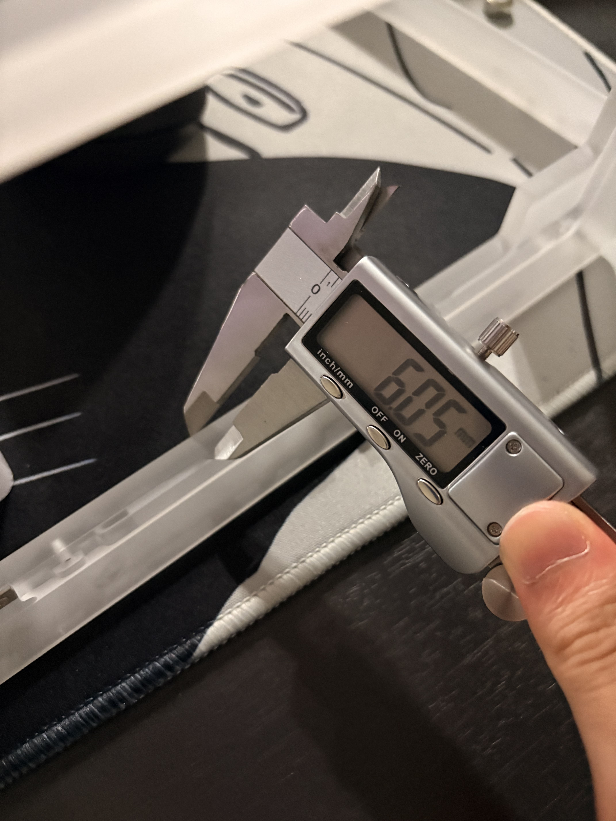
evidence/topcase/photos/IMG_0336.jpg
