minpeter/rule60-wrist-rest/evidence/topcase/photos/IMG_0337.jpg

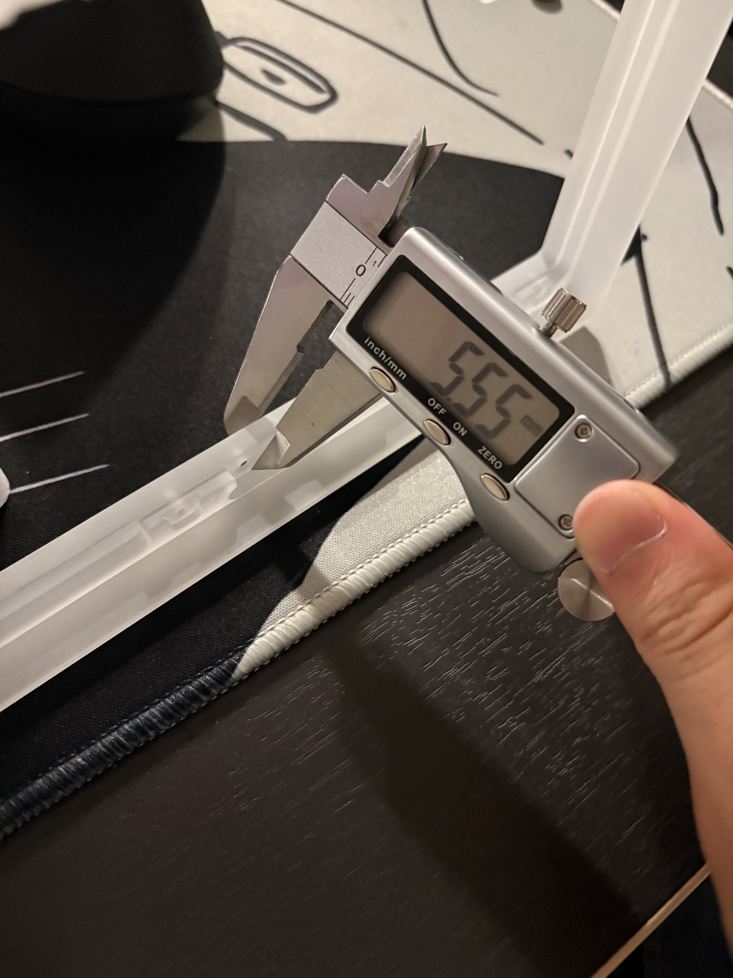
evidence/topcase/photos/IMG_0337.jpg
