minpeter/rule60-wrist-rest/evidence/topcase/photos/IMG_0372.jpg

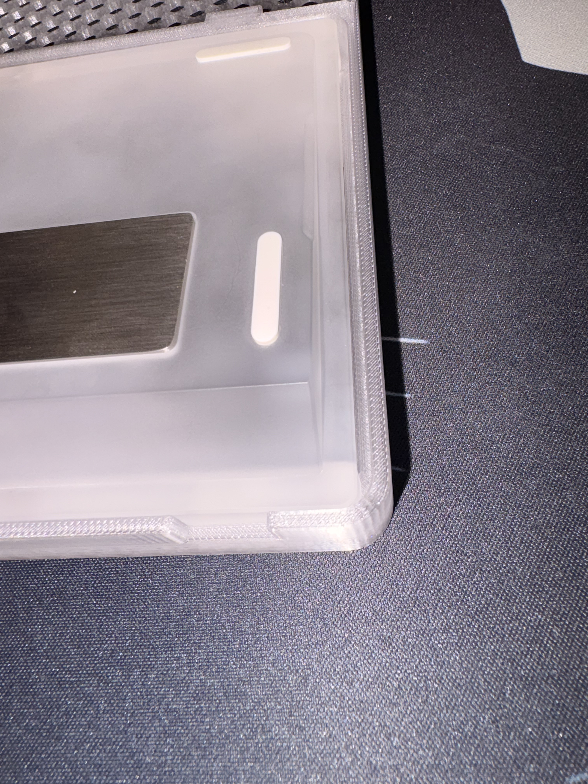
evidence/topcase/photos/IMG_0372.jpg
