minpeter/rule60-wrist-rest/evidence/topcase/photos/IMG_0374.jpg

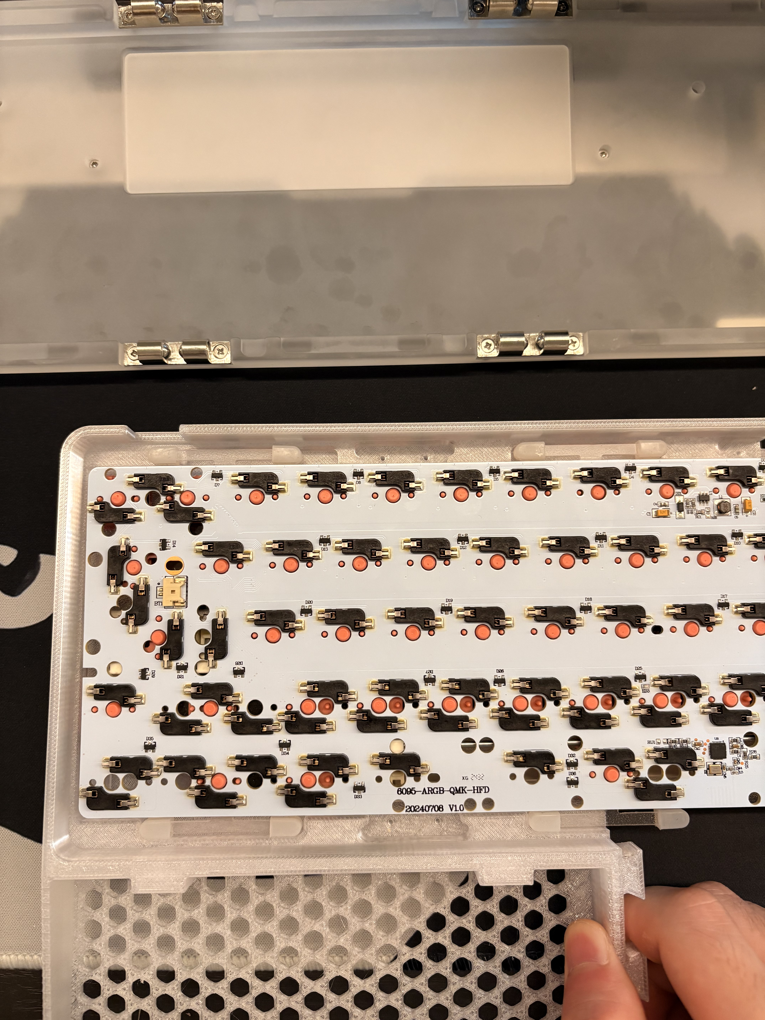
evidence/topcase/photos/IMG_0374.jpg
